Secret624/Dille/Dille.kicad_pcb

## KiCad design Dille.kicad_pcb (2023-12-21)

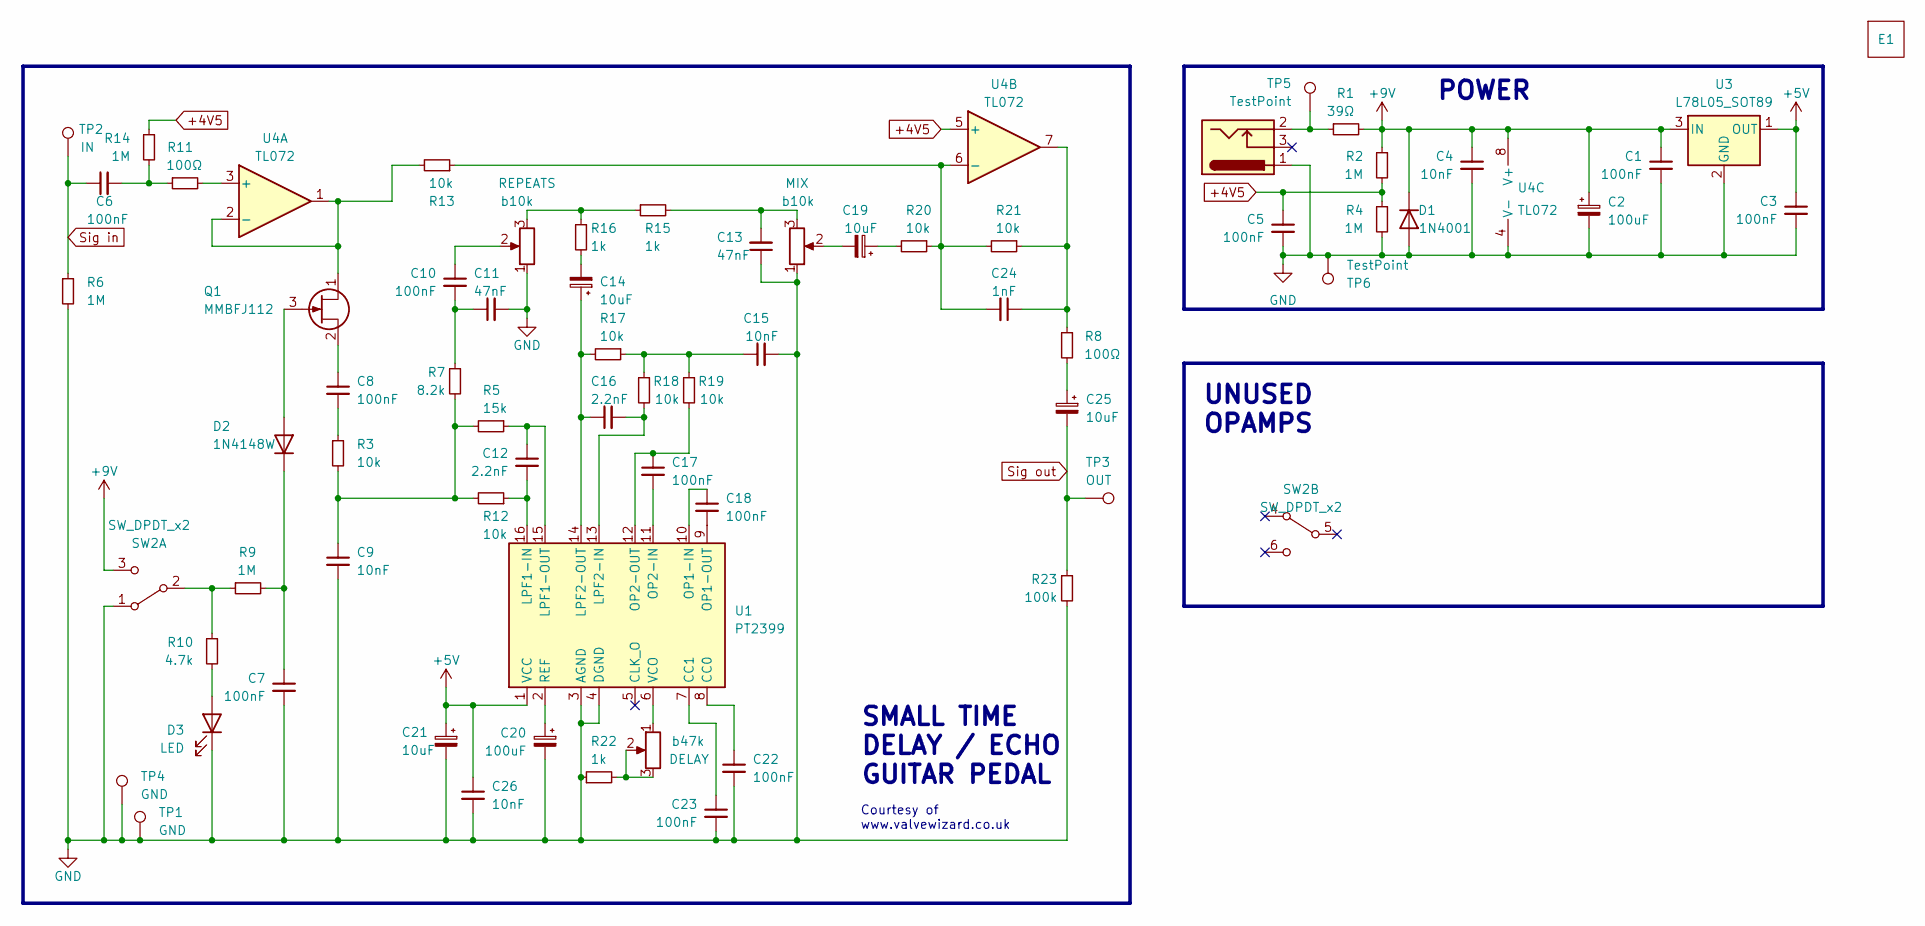
[picture p1: schematic Dille.kicad_sch]

Parts:
C1, C3, C5, C6, C7, C8, C10, C17, C18, C22, C23: 100nF; C_0805_2012Metric_Pad1.18x1.45mm_HandSolder; LCSC# C282730
C2, C20: 100uF; CP_Elec_6.3x4.5; LCSC# C5374787
C4, C9, C15, C26: 10nF; C_0805_2012Metric_Pad1.18x1.45mm_HandSolder; LCSC# C58456
C11, C13: 47nF; C_0805_2012Metric_Pad1.18x1.45mm_HandSolder; LCSC# C282770
C12, C16: 2.2nF; C_0805_2012Metric_Pad1.18x1.45mm_HandSolder; LCSC# C5137580
C14, C19, C21, C25: 10uF; CP_Elec_4x4.5; LCSC# C249787
C24: 1nF; C_0805_2012Metric_Pad1.18x1.45mm_HandSolder; LCSC# C713510
D1: 1N4001; D_SOD-123F; LCSC# C2892326
D2: 1N4148W; D_SOD-123; LCSC# C5345962
D3: LED; LED_D3.0mm
E1: 1590B
J1: Barrel_Jack_Switch; BarrelJack_Kycon_KLDX-0202-xC_Horizontal
Q1: MMBFJ112; SOT-23; LCSC# C258195
R1: 39Ω; R_1206_3216Metric_Pad1.30x1.75mm_HandSolder; LCSC# C153384
R2, R4, R6, R9, R14: 1M; R_0805_2012Metric_Pad1.20x1.40mm_HandSolder; LCSC# C103906
R3, R12, R13, R17, R18, R19, R20, R21: 10k; R_0805_2012Metric_Pad1.20x1.40mm_HandSolder; LCSC# C17414
R5: 15k; R_0805_2012Metric_Pad1.20x1.40mm_HandSolder; LCSC# C2933528
R7: 8.2k; R_0805_2012Metric_Pad1.20x1.40mm_HandSolder; LCSC# C2907342
R8, R11: 100Ω; R_0805_2012Metric_Pad1.20x1.40mm_HandSolder; LCSC# C3016626
R10: 4.7k; R_0805_2012Metric_Pad1.20x1.40mm_HandSolder; LCSC# C2907326
R15, R16, R22: 1k; R_0805_2012Metric_Pad1.20x1.40mm_HandSolder; LCSC# C2907232
R23: 100k; R_0805_2012Metric_Pad1.20x1.40mm_HandSolder; LCSC# C2907293
RV1, RV2: b10k; UT right angle long pin
RV3: b47k; UT right angle long pin
SW2: SW_DPDT_x2; Ural dpdt
TP1, TP4: GND; Test point 2.5x1.5
TP2: IN; Test point 2.5x1.5
TP3: OUT; Test point 2.5x1.5
TP5, TP6: TestPoint; TestPoint_Pad_4.0x4.0mm
U1: PT2399; SOP-16_3.9x9.9mm_P1.27mm; LCSC# C126407
U3: L78L05_SOT89; SOT-89-3; LCSC# C5181466
U4: TL072; SO-8_3.9x4.9mm_P1.27mm

Connections:
+4V5: C5.1, R2.2, R4.1, R14.1, U4.5 (+)
+5V: C3.1, C21.1, C26.1, U1.1 (VCC), U3.1 (OUT)
+9V: C1.1, C2.1, C4.1, D1.1 (K), R1.2, R2.1, SW2.3 (C), U3.3 (IN), U4.8 (V+)
GND: C1.2, C2.2, C3.2, C4.2, C5.2, C7.2, C9.2, C11.2, C13.1, C15.2, C20.2, C21.2, C22.2, C23.2, C26.2, D1.2 (A), D3.1 (K), J1.1, R4.2, R6.2, R22.1, R23.2, RV1.1, RV2.1, SW2.1 (A), TP1.1, TP4.1, TP6.1, U1.3 (AGND), U1.4 (DGND), U3.2 (GND), U4.4 (V-); also elsewhere on the board
unnamed: C6.2, R11.1, R14.2
unnamed: C8.2, R3.1
unnamed: C9.1, R3.2, R5.2, R7.2, R12.2
unnamed: C10.1, RV1.2
unnamed: C10.2, C11.1, R7.1
unnamed: C13.2, R15.2, RV2.3
unnamed: C14.2, R16.2
unnamed: C15.1, R17.1, R18.1, R19.1
unnamed: C19.1, R20.2
unnamed: C19.2, RV2.2
unnamed: C24.1, R8.1, R21.1, U4.7
unnamed: C25.1, R8.2
unnamed: D2.2 (A), Q1.3 (G)
unnamed: C7.1, D2.1 (K), R9.2
unnamed: D3.2 (A), R10.2
unnamed 19: J1.2, R1.1, TP5.1; also elsewhere on the board
unnamed: Q1.1 (D), R13.2, U4.1, U4.2 (-)
unnamed: C8.1, Q1.2 (S)
unnamed: R15.1, R16.1, RV1.3
unnamed: R22.2, RV3.2, RV3.3
unnamed: R9.1, R10.1, SW2.2 (B)
unnamed: C22.1, U1.8 (CC0)
unnamed: C23.1, U1.7 (CC1)
unnamed: C12.2, R12.1, U1.16 (LPF1-IN)
unnamed: C12.1, R5.1, U1.15 (LPF1-OUT)
unnamed: C16.2, R18.2, U1.13 (LPF2-IN)
unnamed: C14.1, C16.1, R17.2, U1.14 (LPF2-OUT)
unnamed: C18.1, U1.10 (OP1-IN)
unnamed: C18.2, U1.9 (OP1-OUT)
unnamed: C17.2, U1.11 (OP2-IN)
unnamed: C17.1, R19.2, U1.12 (OP2-OUT)
unnamed: C20.1, U1.2 (REF)
unnamed: RV3.1, U1.6 (VCO)
unnamed: R11.2, U4.3 (+)
unnamed: C24.2, R13.1, R20.1, R21.2, U4.6 (-)
Sig in: C6.1, R6.1, TP2.1
Sig out: C25.2, R23.1, TP3.1

Notes on the sheet:
Courtesy of www.valvewizard.co.uk
UNUSED OPAMPS
POWER
SMALL TIME DELAY / ECHO GUITAR PEDAL

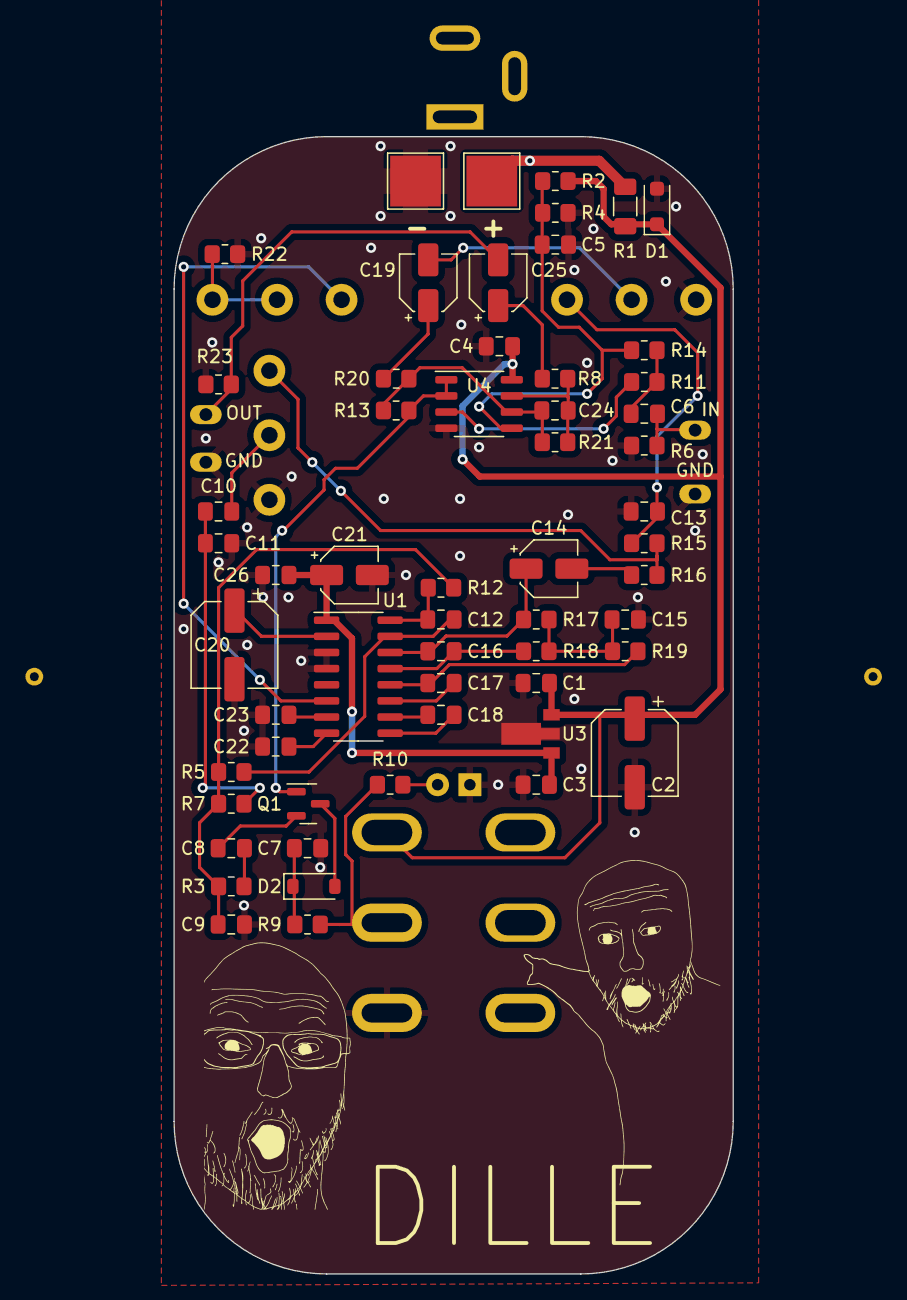
[picture p2: board Dille.kicad_pcb from above]

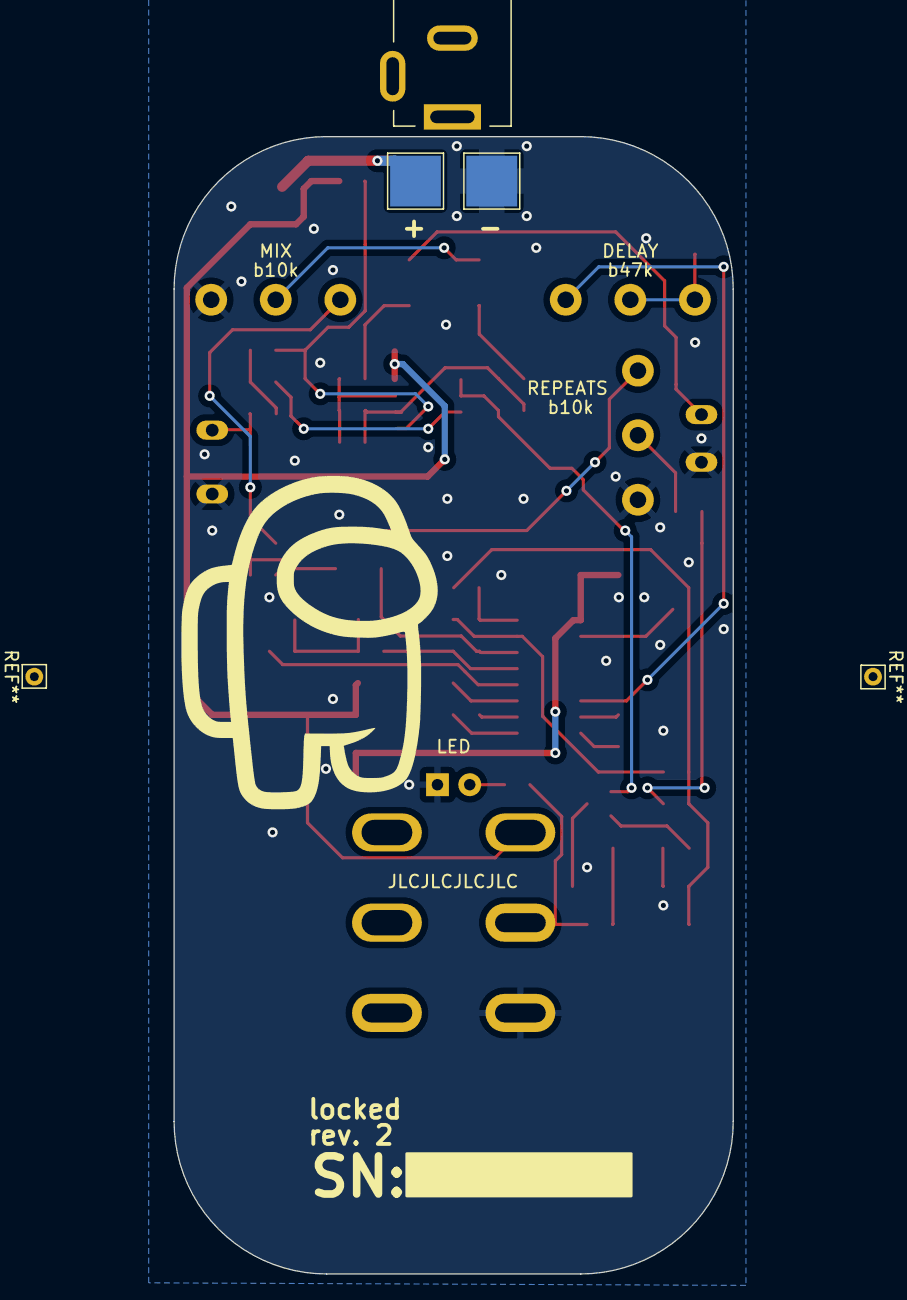
[picture p3: board Dille.kicad_pcb from below]

Board: 2 copper layers, 44.0 x 89.5 mm, 70 parts (9 on the bottom side), 41 nets.

Other parts of the board:
TP5#2, TP6#2: TestPoint; TestPoint_Pad_4.0x4.0mm

Their connections:
GND: TP6#2.1; also elsewhere on the board
unnamed 19: TP5#2.1; also elsewhere on the board
