Secret624/Dille/(commit log)

2023-11-05 pcb 2
    [Dille.kicad_pcb, Dille.kicad_sch]
2023-11-18 Added gerbers
    [Dille-B_Cu.gbr, Dille-B_Mask.gbr, Dille-B_Paste.gbr, Dille-B_Silkscreen.gbr, Dille-Edge_Cuts.gbr, Dille-F_Cu.gbr, Dille-F_Mask.gbr, Dille-F_Paste.gbr]
2023-12-14 Rev 2
    [Dille.kicad_pcb, Dille.kicad_sch]
2023-12-15 Silkscreen updated
    [Dille.kicad_pcb, Dille.kicad_sch]
2023-12-21 Revision 2
    [Dille.kicad_pcb, Dille.kicad_sch]
